amaltsev/battery-chart/hardware/images/bc-cpu-sch.pdf

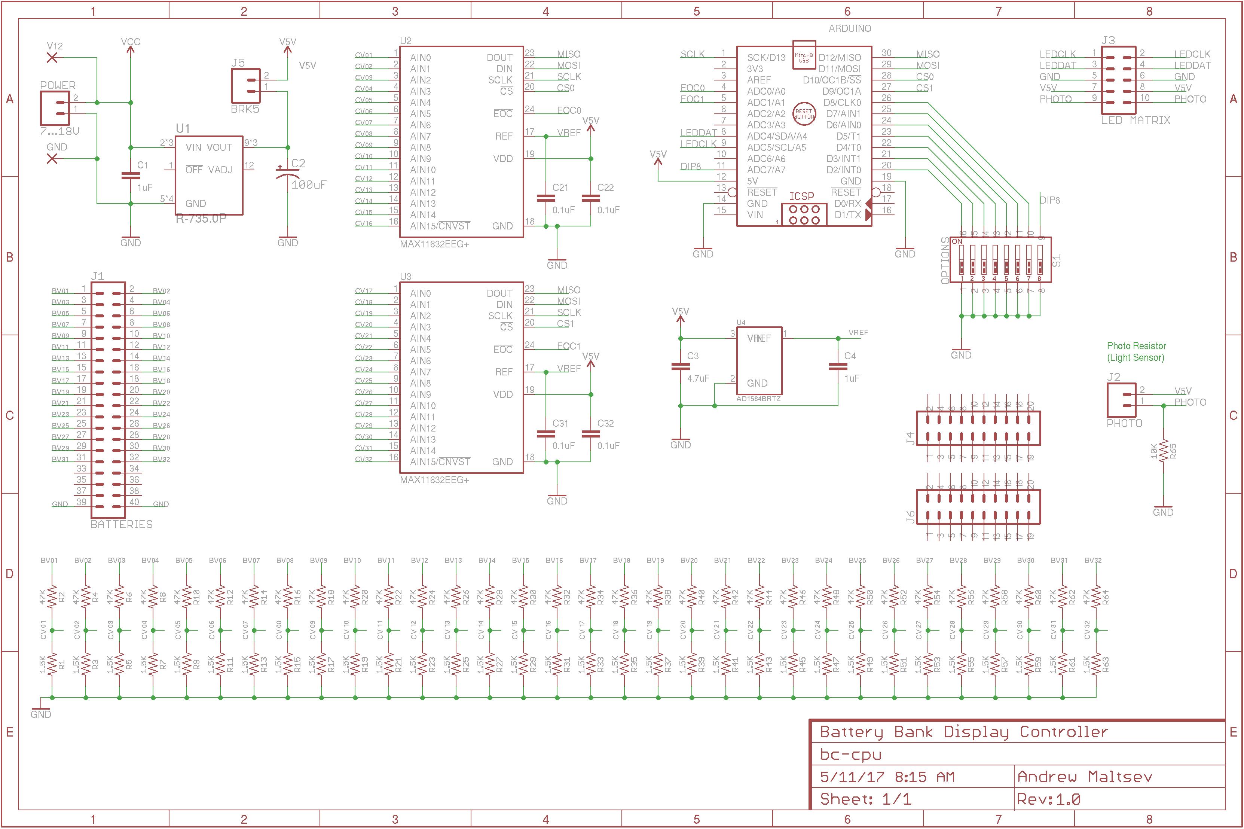
[picture p1: page 1]
