amaltsev/battery-chart/hardware/images/bc-cpu-btm.png

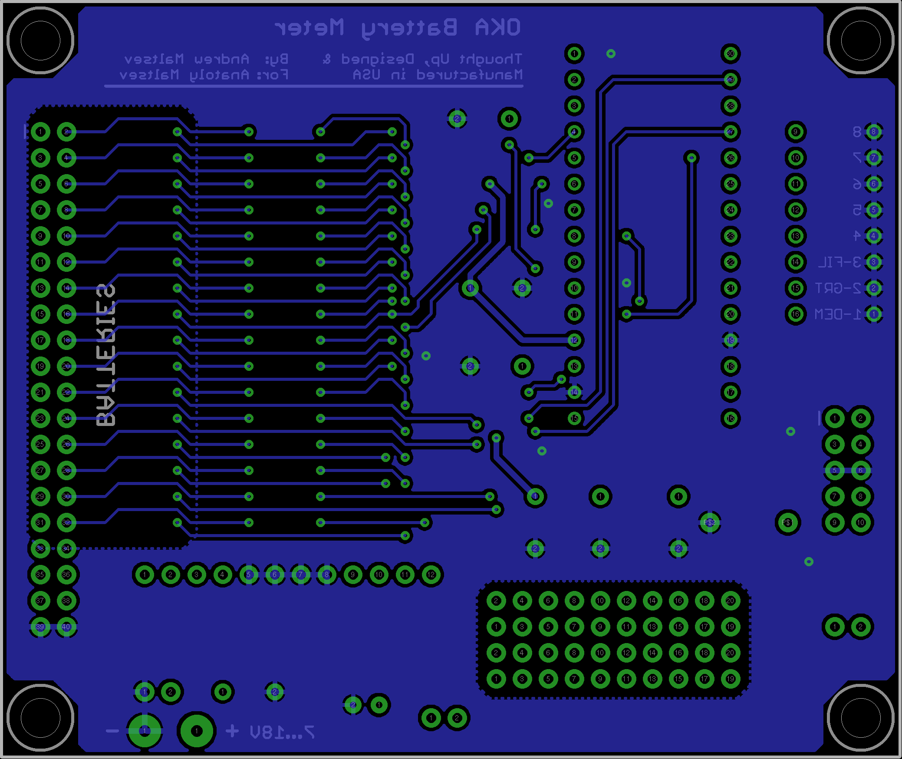
hardware/images/bc-cpu-btm.png
