amaltsev/battery-chart/hardware/images/bc-cpu-top.png

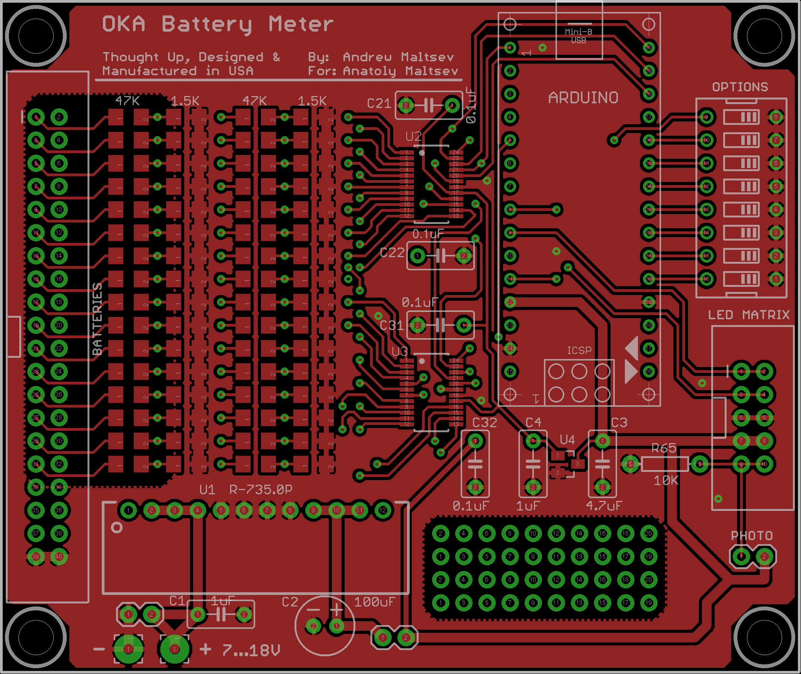
hardware/images/bc-cpu-top.png
