amaltsev/battery-chart/hardware/images/bc-cpu-btm.pdf

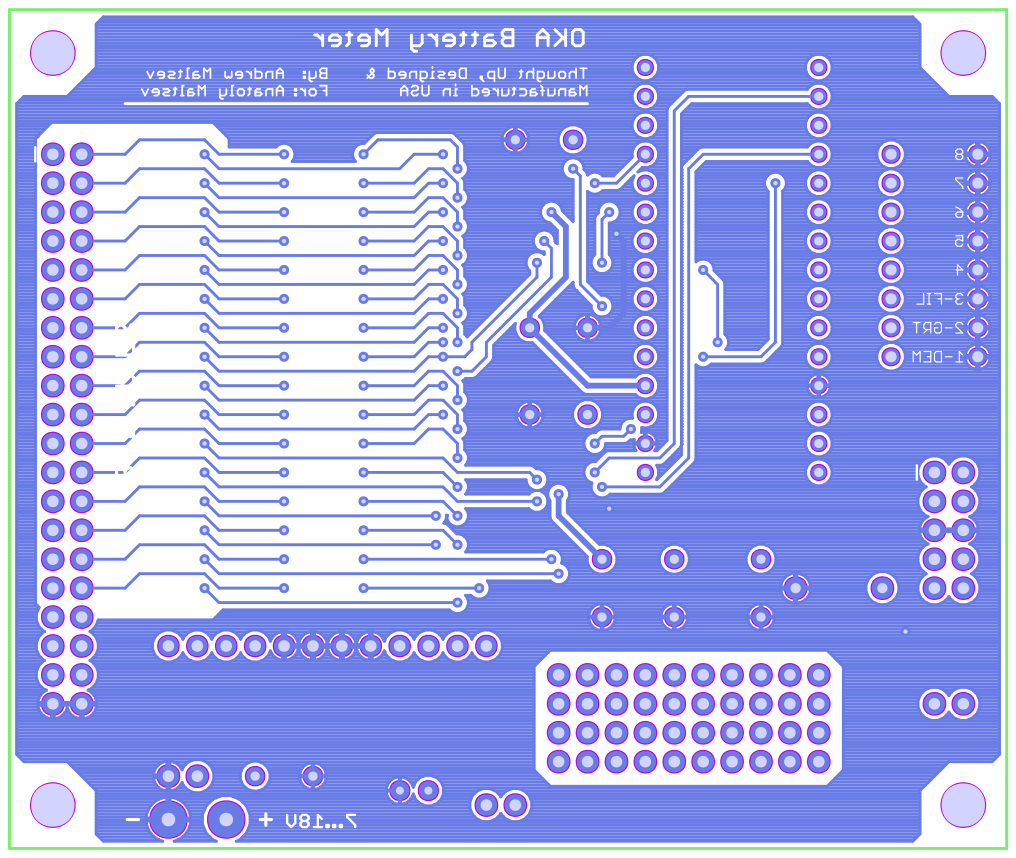
[picture p4: page 1]
