amaltsev/battery-chart/hardware/images/bc-cpu-top.pdf

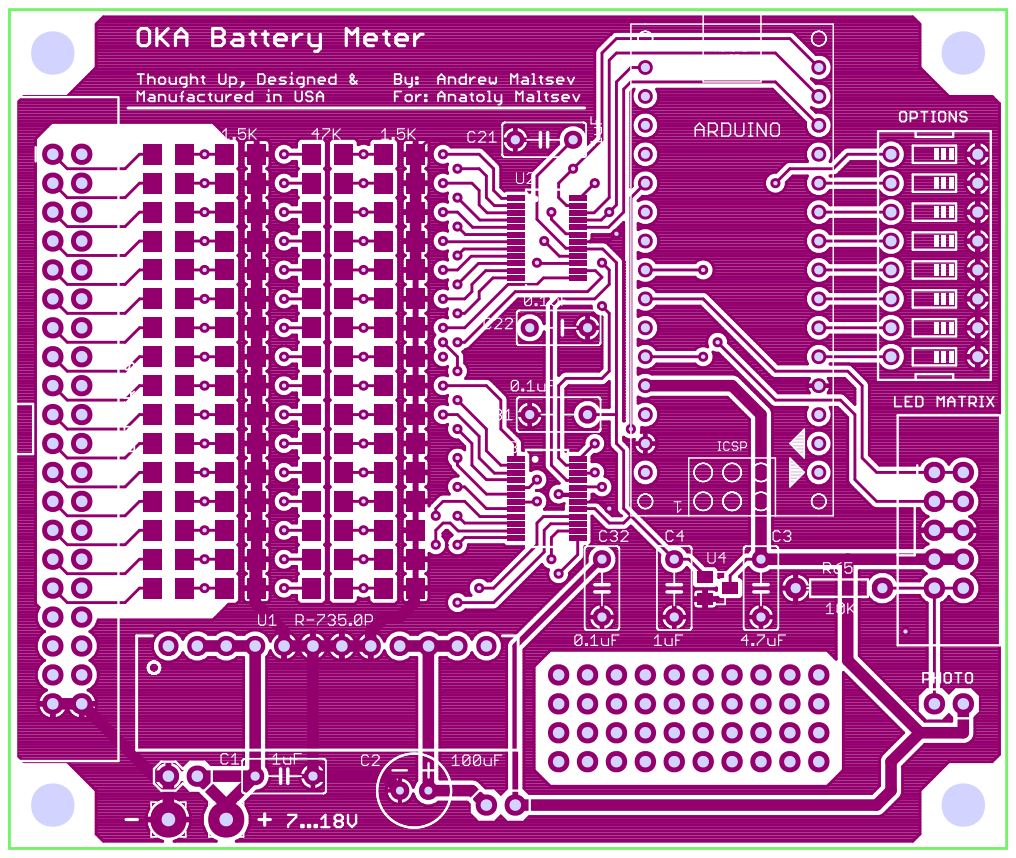
[picture p5: page 1]
