amaltsev/battery-chart/hardware/bc-cpu.brd

## EAGLE design hardware/bc-cpu.brd (2017-06-01)

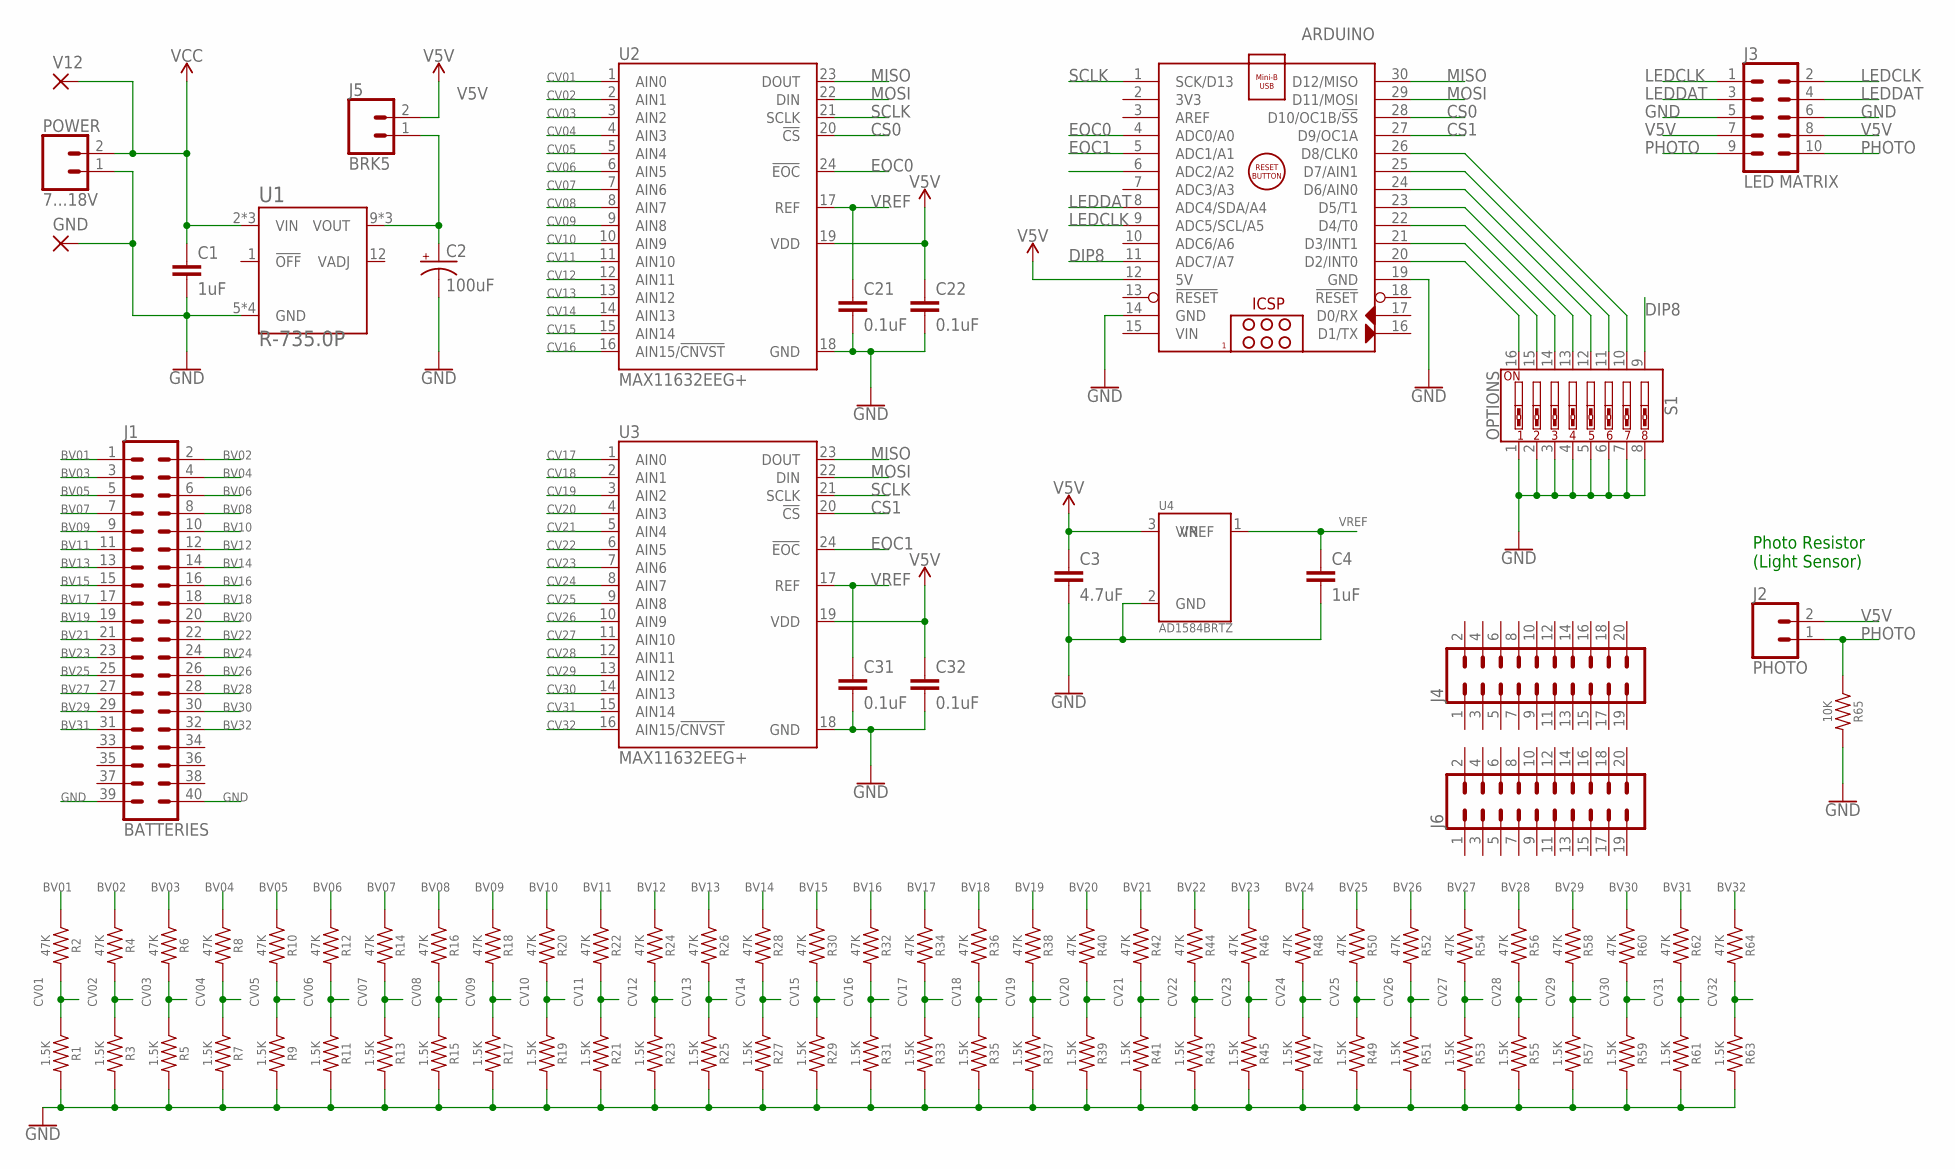
[picture p6: schematic bc-cpu.sch]

Parts:
ARDUINO: ARDUINO_NANO
C1, C4: 1uF; C5B3
C2: 100uF; CPOL-RADIAL-2.5MM-6.5MM
C3: 4.7uF; C5B3
C21, C22, C31, C32: 0.1uF; C5B3
GND: WIREPAD3,17/1,2; 3,17/1,2
J1: BATTERIES; 2X20_SHROUDED
J2: PHOTO; 1X02
J3: LED MATRIX; 2X5-SHROUDED
J4, J6: CONN_10X2NOSILK; 2X10_NOSILK
J5: BRK5; 1X02
POWER: 7...18V; 1X02
R1, R3, R5, R7, R9, R11, R13, R15, R17, R19, R21, R23, R25, R27, R29, R31, R33, R35, R37, R39, R41, R43, R45, R47, R49, R51, R53, R55, R57, R59, R61, R63: 1.5K; 1206
R2, R4, R6, R8, R10, R12, R14, R16, R18, R20, R22, R24, R26, R28, R30, R32, R34, R36, R38, R40, R42, R44, R46, R48, R50, R52, R54, R56, R58, R60, R62, R64: 47K; 1206
R65: 10K; AXIAL-0.3
S1: OPTIONS; DIPSWITCH-08
U1: R-735.0P; RECOM-R-7XX.XX
U2, U3: MAX11632EEG+; QSOP24
U4: AD1584BRTZ; SOT23-3
V12: WIREPAD3,17/1,2; 3,17/1,2

Connections:
BV01: J1.1, R2.1
BV02: J1.2, R4.1
BV03: J1.3, R6.1
BV04: J1.4, R8.1
BV05: J1.5, R10.1
BV06: J1.6, R12.1
BV07: J1.7, R14.1
BV08: J1.8, R16.1
BV09: J1.9, R18.1
BV10: J1.10, R20.1
BV11: J1.11, R22.1
BV12: J1.12, R24.1
BV13: J1.13, R26.1
BV14: J1.14, R28.1
BV15: J1.15, R30.1
BV16: J1.16, R32.1
BV17: J1.17, R34.1
BV18: J1.18, R36.1
BV19: J1.19, R38.1
BV20: J1.20, R40.1
BV21: J1.21, R42.1
BV22: J1.22, R44.1
BV23: J1.23, R46.1
BV24: J1.24, R48.1
BV25: J1.25, R50.1
BV26: J1.26, R52.1
BV27: J1.27, R54.1
BV28: J1.28, R56.1
BV29: J1.29, R58.1
BV30: J1.30, R60.1
BV31: J1.31, R62.1
BV32: J1.32, R64.1
CS0: ARDUINO.28 (D10/OC1B/!SS), U2.20 (!CS)
CS1: ARDUINO.27 (D9/OC1A), U3.20 (!CS)
CV01: R1.1, R2.2, U2.1 (AIN0)
CV02: R3.1, R4.2, U2.2 (AIN1)
CV03: R5.1, R6.2, U2.3 (AIN2)
CV04: R7.1, R8.2, U2.4 (AIN3)
CV05: R9.1, R10.2, U2.5 (AIN4)
CV06: R11.1, R12.2, U2.6 (AIN5)
CV07: R13.1, R14.2, U2.7 (AIN6)
CV08: R15.1, R16.2, U2.8 (AIN7)
CV09: R17.1, R18.2, U2.9 (AIN8)
CV10: R19.1, R20.2, U2.10 (AIN9)
CV11: R21.1, R22.2, U2.11 (AIN10)
CV12: R23.1, R24.2, U2.12 (AIN11)
CV13: R25.1, R26.2, U2.13 (AIN12)
CV14: R27.1, R28.2, U2.14 (AIN13)
CV15: R29.1, R30.2, U2.15 (AIN14)
CV16: R31.1, R32.2, U2.16 (AIN15/!CNVST)
CV17: R33.1, R34.2, U3.1 (AIN0)
CV18: R35.1, R36.2, U3.2 (AIN1)
CV19: R37.1, R38.2, U3.3 (AIN2)
CV20: R39.1, R40.2, U3.4 (AIN3)
CV21: R41.1, R42.2, U3.5 (AIN4)
CV22: R43.1, R44.2, U3.6 (AIN5)
CV23: R45.1, R46.2, U3.7 (AIN6)
CV24: R47.1, R48.2, U3.8 (AIN7)
CV25: R49.1, R50.2, U3.9 (AIN8)
CV26: R51.1, R52.2, U3.10 (AIN9)
CV27: R53.1, R54.2, U3.11 (AIN10)
CV28: R55.1, R56.2, U3.12 (AIN11)
CV29: R57.1, R58.2, U3.13 (AIN12)
CV30: R59.1, R60.2, U3.14 (AIN13)
CV31: R61.1, R62.2, U3.15 (AIN14)
CV32: R63.1, R64.2, U3.16 (AIN15/!CNVST)
DIP1: ARDUINO.20 (D2/INT0), S1.16
DIP2: ARDUINO.21 (D3/INT1), S1.15
DIP3: ARDUINO.22 (D4/T0), S1.14
DIP4: ARDUINO.23 (D5/T1), S1.13
DIP5: ARDUINO.24 (D6/AIN0), S1.12
DIP6: ARDUINO.25 (D7/AIN1), S1.11
DIP7: ARDUINO.26 (D8/CLK0), S1.10
DIP8: ARDUINO.11 (ADC7/A7), S1.9
EOC0: ARDUINO.4 (ADC0/A0), U2.24 (!EOC)
EOC1: ARDUINO.5 (ADC1/A1), U3.24 (!EOC)
GND: ARDUINO.14 (GND), ARDUINO.19 (GND), C1.2, C2.2 (-), C3.2, C4.2, C21.2, C22.2, C31.2, C32.2, GND.1, J1.39, J1.40, J3.5, J3.6, POWER.1, R1.2, R3.2, R5.2, R7.2, R9.2, R11.2, R13.2, R15.2, R17.2, R19.2, R21.2, R23.2, R25.2, R27.2, R29.2, R31.2, R33.2, R35.2, R37.2, R39.2, R41.2, R43.2, R45.2, R47.2, R49.2, R51.2, R53.2, R55.2, R57.2, R59.2, R61.2, R63.2, R65.P$2 (2), S1.1, S1.2, S1.3, S1.4, S1.5, S1.6, S1.7, S1.8, U1.5 (GND), U1.6 (GND), U1.7 (GND), U1.8 (GND), U2.18 (GND), U3.18 (GND), U4.2 (GND)
LEDCLK: ARDUINO.9 (ADC5/SCL/A5), J3.1, J3.2
LEDDAT: ARDUINO.8 (ADC4/SDA/A4), J3.3, J3.4
MISO: ARDUINO.30 (D12/MISO), U2.23 (DOUT), U3.23 (DOUT)
MOSI: ARDUINO.29 (D11/MOSI), U2.22 (DIN), U3.22 (DIN)
unnamed: C2.1 (+), J5.1, U1.9 (VOUT), U1.10 (VOUT), U1.11 (VOUT)
PHOTO: ARDUINO.6 (ADC2/A2), J2.1, J3.9, J3.10, R65.P$1 (1)
SCLK: ARDUINO.1 (SCK/D13), U2.21 (SCLK), U3.21 (SCLK)
V5V: ARDUINO.12 (5V), C3.1, C22.1, C32.1, J2.2, J3.7, J3.8, J5.2, U2.19 (VDD), U3.19 (VDD), U4.3 (VIN)
VCC: C1.1, POWER.2, U1.2 (VIN), U1.3 (VIN), U1.4 (VIN), V12.1
VIN: ARDUINO.15 (VIN)
VREF: C4.1, C21.1, C31.1, U2.17 (REF), U3.17 (REF), U4.1 (VREF)

Notes on the sheet:
Photo Resistor (Light Sensor)

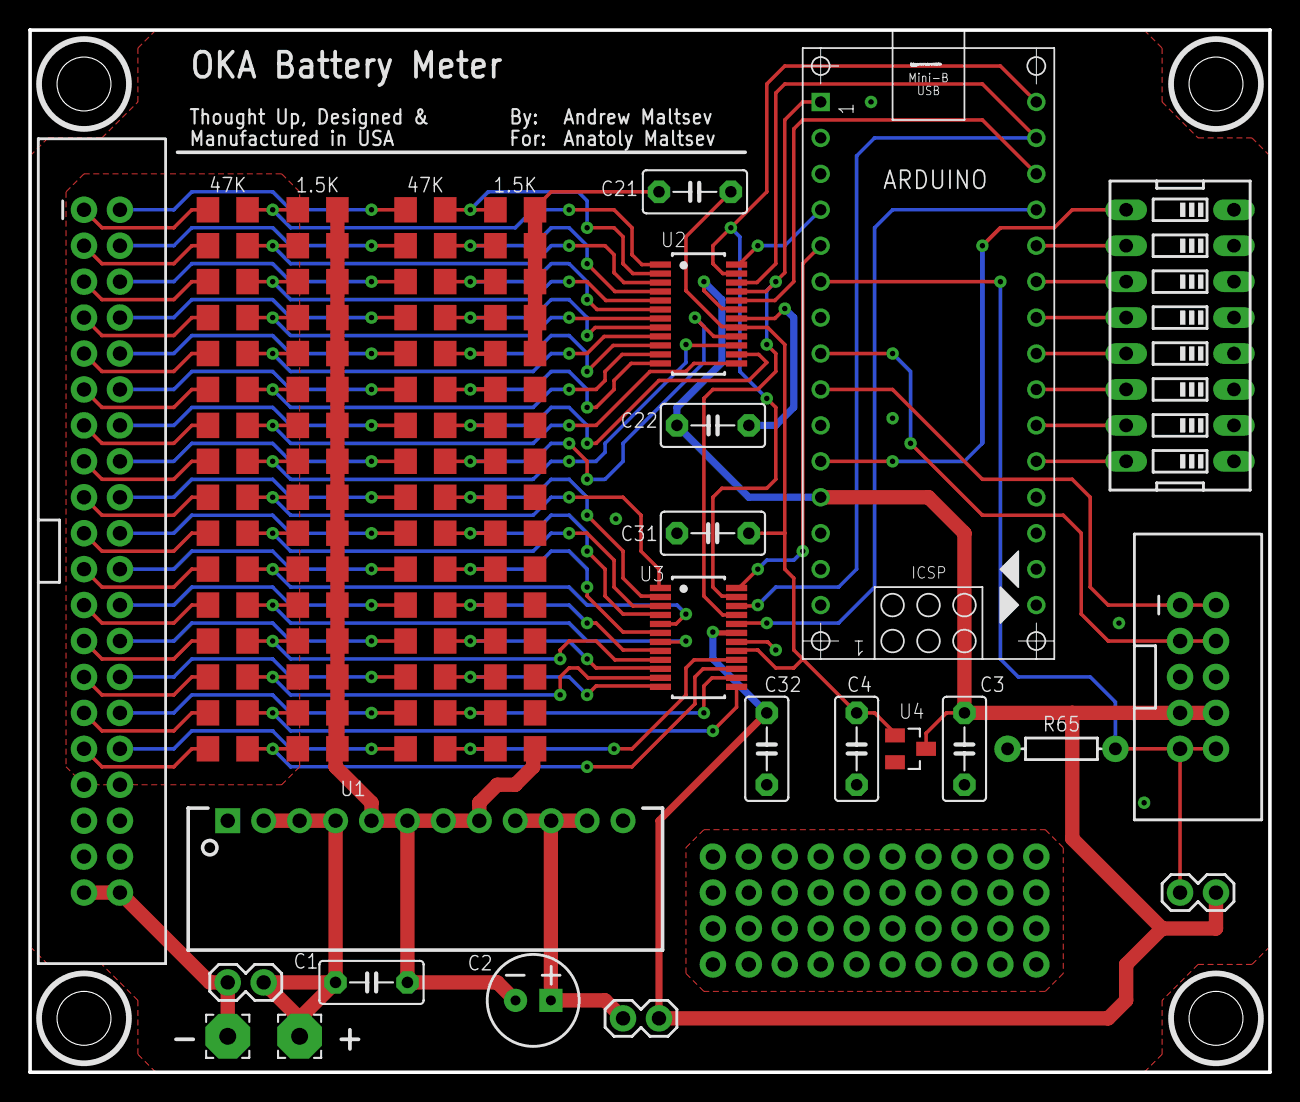
[picture p7: board bc-cpu.brd from above]

Board: 2 copper layers, 87.6 x 73.7 mm, 88 parts (0 on the bottom side), 87 nets.
