amaltsev/battery-chart/software/bc-display/Display.h

#ifndef Oka_Display_h
#define Oka_Display_h

#include "Config.h"
#include "Voltage.h"
#include "MultiMatrix.h"

// The display controller.
//
// It does not have much poing being a class, but easier to code that way.
//
class Display {
  public:
    Display();
    void setup();
    void loop(Voltage &vdata);

  protected:
    void chart(Voltage &vdata);
    void greeting();
    void drawColumn(uint8_t n, uint8_t v);
    void drawWarning(uint8_t x, bool w1, bool w2);
    
    MultiMatrix matrix=MultiMatrix(4,LED_MATRIX_IDS);
    bool greetingShown=false;
    uint8_t blinkPhase=0;
    uint8_t pixelCap=255;
    uint8_t pixelValues[VCHANNELS];

    int     brsamples[BRIGHTNESS_SAMPLES];
    int8_t  brindex=-1;
    
    uint8_t brightness=0;
};

#endif // Oka_Display_h
