amaltsev/battery-chart/software/bc-display/Voltage.h

#ifndef Oka_Voltage_h
#define Oka_Voltage_h

#include "Config.h"

// Reading voltage for all channels.
//
class Voltage {
  public:
    Voltage() {
      memset(volts,0,sizeof(volts));
    };

    // Initial setup
    //
    virtual void setup()=0;
    
    // Measure and remember all channels.
    //
    virtual void measureAll()=0;

    // Calculated voltage for any given line, in volts.
    //
    float getLine(uint8_t c) {
      return c<VCHANNELS ? volts[c] : -1;
    }

    // Grand total voltage across all lines, in volts.
    //
    float getTotal() {
      return total;
    }

    // Get the index of the first active channel number.
    //
    uint8_t getChannelFirst() {
      return cFirst;
    }

    // Get the index of the last active channel number.
    //
    uint8_t getChannelLast() {
      return cLast;
    }

    // Get the count of active channels (how many banks we're actually
    // measuring, even if there are gaps and disconnects).
    //
    uint8_t getActiveCount() {
      return nActive;
    }

    // Debug dump of the read values
    //
    void dump() {
      if(!DEBUG_VOLTAGE) return;
      Serial << "Active: " << getActiveCount() << "/" << getChannelFirst() << "/" << getChannelLast() << " ";
      Serial << "Total: " << getTotal() << " - ";
      for(uint8_t c=0; c<31; c++) {
        float v=getLine(c);
        if(v) {
          Serial << c << "=" << v << " ";
        }
      }
      Serial.println("");
    }

  protected:
    float volts[VCHANNELS];
    float total=0;
    uint8_t cFirst=VCHANNELS;
    uint8_t cLast=VCHANNELS;
    uint8_t nActive=0;

    void updateFirstLast() {
      cFirst=0;
      while(cFirst<VCHANNELS && volts[cFirst]==0) ++cFirst;
      if(cFirst>=VCHANNELS) cFirst=0;
  
      cLast=VCHANNELS-1;
      while(cLast>cFirst && volts[cLast]==0) --cLast;
    }
};

// Real readings from MAX-11632 chips and resistor dividers.
//
class VoltageBoard : public Voltage {
  public:
    VoltageBoard() {
      memset(volts,0,sizeof(volts));
    };

    virtual void setup();
    virtual void measureAll();
  private:
    int16_t input[VCHANNELS];
};

// Demo (randomized) voltage readings
//
class VoltageDemo : public Voltage {
  public:
    virtual void setup();
    virtual void measureAll();
  private:
    uint8_t phase=0;
    int16_t step=0;
    void nextStep(int16_t maxStep);
};

// Interface to MAX-11632 ADC
//
void max11632_setup(int pin_chip_select, int pin_eoc);
int16_t max11632_read(uint8_t channel, int pin_chip_select, int pin_eoc, uint16_t refv);

#endif // Oka_Voltage_h
