amaltsev/battery-chart/software/bc-display/VoltageDemo.cpp

#include "Config.h"
#include "Voltage.h"

static const uint8_t DEMOCHAN=30;
static const uint8_t MINPHASE=4;

// Initial setup
//
void VoltageDemo::setup() {
  phase=MINPHASE;

  for(uint8_t i=0; i<DEMOCHAN; ++i) {
    volts[i]=random(0,400)/1000.0+3.6;
  } 
}
    
// Generate test values
//
void VoltageDemo::measureAll() {
//  if(DEBUG_VOLTAGE) {
//    Serial << "--- Phase=" << phase << " step=" << step << "\n";
//  }

  // Generating values from Min to Max in a ladder pattern
  //
  if(phase==0) {
    volts[step]=CHART_VOLT_MIN + step * (CHART_VOLT_MAX - CHART_VOLT_MIN)/(DEMOCHAN-1);
    
    nextStep(DEMOCHAN);
  }

  // Instant charge.
  //
  else if(phase==1) {
    volts[step]=CHART_VOLT_MAX;
    
    nextStep(DEMOCHAN);
  }

  // Gaps/disconnects.
  //
  else if(phase==2) {
    if(step==0)
      volts[0]=0;
    else
      volts[random(0,DEMOCHAN)]=0;
      
    nextStep(10);
  }

  // Hysteresis testing, jumping around with noise
  //
  else if(phase==3) {
    if(step==0) {
      for(uint8_t i=0; i<DEMOCHAN; ++i)
        volts[i]=0;
      volts[0]=3.8;
    }

    if(step<10)
      volts[0]+=0.02;
    else if(step<20)
      volts[0]-=0.02;
    
    // volts[0]+=random(-100,100)/1000.0;

    nextStep(20);
  }
  
  // Slowly charging.
  //
  else if(phase==4) {
    bool haveWork=false;
    
    for(uint8_t i=0; i<DEMOCHAN; ++i) {
      if(volts[i]<CHART_VOLT_MAX) {
        if(volts[i]==0)
          volts[i]=CHART_VOLT_MIN - 0.1;
        else
          volts[i]+=random(-5,60)/1000.0;
          
        haveWork=true;
      }
    }
    
    if(!haveWork)
      phase=4;
  }

  // Slow full discharge.
  //
  else {
    bool haveWork=false;

    for(uint8_t i=0; i<DEMOCHAN; ++i) {
      if(volts[i]>CHART_VOLT_MAX/2) {
        volts[i]-=random(-5,40)/1000.0;
        haveWork=true;
      }
    }

    if(!haveWork) {
      phase=MINPHASE;
      step=0;
    }
  }

  // Got the data, analyzing
  //
  nActive=0;
  total=0;
  for(uint8_t i=0; i<VCHANNELS; ++i) {
    if(volts[i]) {
      total+=volts[i];
      ++nActive;
    }
  }

  updateFirstLast();
}

void VoltageDemo::nextStep(int16_t maxStep) {
  if(++step >= maxStep) {
    ++phase;
    step=0;
  }
}
