amaltsev/battery-chart/(commit log)

2017-05-08 Initial commit
    Incomplete schematic, just building library parts and starting...
    [bc-cpu.sch]
2017-05-08 Added resistors array
    [bc-cpu.sch]
2017-05-08 Added voltage reference
    [bc-cpu.sch]
2017-05-09 Final schematic, before PCB
    [bc-cpu.sch]
2017-05-09 The initial rats nest
    [bc-cpu.brd, bc-cpu.sch]
2017-05-09 Rough placement, no routes
    [bc-cpu.brd]
2017-05-10 Layout attempt with SMD MAX-11632
    Lots of random traces that need to be placed by hand. Committing before
    trying a different approach.
    [bc-cpu.brd, bc-cpu.sch]
2017-05-10 More organized routing
    This starts to look like it might work... :)
    [bc-cpu.brd]
2017-05-10 ADC 1 mostly routed
    [bc-cpu.brd]
2017-05-10 Fixed VREF bug, mostly routed
    [bc-cpu.brd, bc-cpu.sch]
2017-05-11 All routed, DRC checks passing
    Also removed drill holes from Arduino Nano lib -- they were translating
    into the board for no reason. Replaced them with just silkscreen.
    [bc-cpu.brd, bc-cpu.sch]
2017-05-11 Text, labels, positioning
    [bc-cpu.brd, bc-cpu.sch]
2017-05-11 Power input adjustments
    [bc-cpu.brd, bc-cpu.sch]
2017-05-11 Changed font to vector
    [bc-cpu.brd]
2017-05-11 Extra air gap around inputs
    120V is not going to bridge even 1mil, but removed copper pour around
    terminals just in case anyway.
    [bc-cpu.brd]
2017-05-11 Gerber output - off to Fabrication
    [bc-cpu.GBL, bc-cpu.GBO, bc-cpu.GBS, bc-cpu.GKO, bc-cpu.GTL, bc-cpu.GTO, bc-cpu.GTP, bc-cpu.GTS]
2017-05-21 Final board, as ordered from OSHPark
    [bc-cpu.GBL, bc-cpu.GBO, bc-cpu.GBS, bc-cpu.GKO, bc-cpu.GTL, bc-cpu.GTO, bc-cpu.GTP, bc-cpu.GTS]
2017-05-29 Added voltage reader, calibrated
    Readings are VERY consistent. I expected accuracy, but not actually at
    that level, where values are exactly identical over all 32 channels and
    over hundreds of measures.
2017-05-29 Fixed calibration typo and recalibrated
    Still consistent enough, to within 1/153rd of the value after division,
    or about 32mV in the source value -- below what can be displayed.
2017-05-29 Actual voltage measuring and conversion
    Works great in initial tests. Allows for connecting input in any order,
    compensates for broken connections.
    [Config.h, MAX-11632.cpp, MultiMatrix.cpp, MultiMatrix.h, Voltage.h, VoltageBoard.cpp, VoltageDemo.cpp, bc-display.ino]
2017-05-30 DIP Switch Options
2017-05-30 Voltage chart works!
    Supports options: rotation, fill, draw bottom. Displays banks and total
    on the far right if there is space for it.
2017-05-30 Demo/Test mode added
    Controlled with DIP Switch 1.
2017-05-30 Added blinking bottom pixes when low voltage
2017-05-30 Hysteresis attempt, not a good one
    Tried to add a bit of hysteresis to avoid pixel blinking at borderline
    values. Did that at voltage input level, which is probably too precise.
    Move it to display at pixel level?
    [Config.h, Display.cpp, Voltage.h, VoltageBoard.cpp]
2017-05-31 A better and simpler hysteresis implementation
    Just math, no buffer. Having different cut-off fractions depending on
    the current state of the column -- essentially resisisting changes.
2017-06-01 Fixed display bug with live disconnects
    It did not clear measured values when some were disconnected during run
    time.
    [Config.h, Voltage.h, VoltageBoard.cpp, VoltageDemo.cpp, bc-display.ino]
2017-06-01 Ambient brightness sensor and reaction
    Fixed the hardware -- forgot to wire the photosensor :(
    Added display brightness adjustment to the ambient light, with a 10
    second averaging.
    [bc-cpu.brd, bc-cpu.sch]
